menendezdiaz/TemperatureController/images/SETUPreal.png

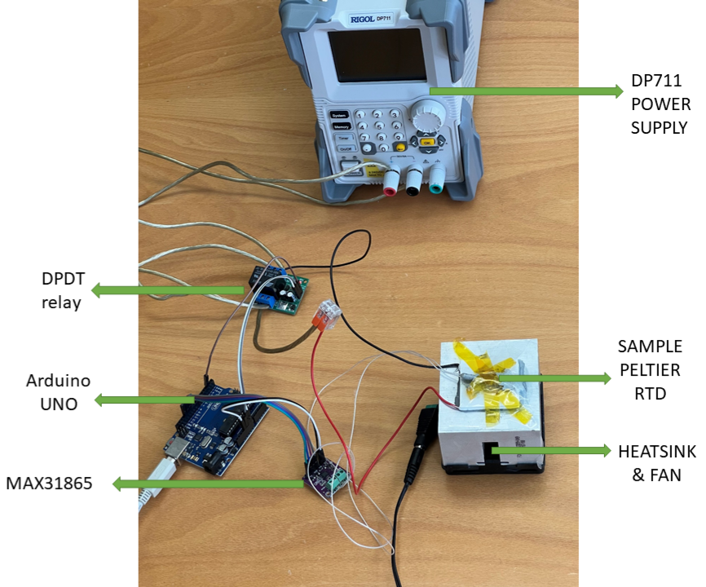
images/SETUPreal.png
